15835229565/BMS_SLAVE_V2.0/README.md

BMS_SLAVE_V2.0
==============

ATtiny13 sourec code for HW version 2.0
