15835229565/BMS_SLAVE_V2.0/(list of files, cad)

Other CAD files:
Software/AtTiny_programmer/RC calib Projekt/rc_calib.obj
