15835229565/BMS_SLAVE_V2.0/Hardware/Eagle_project/BMS_Slave_V2.0.brd

## EAGLE design Hardware/Eagle_project/BMS_Slave_V2.0.brd (2015-01-06)

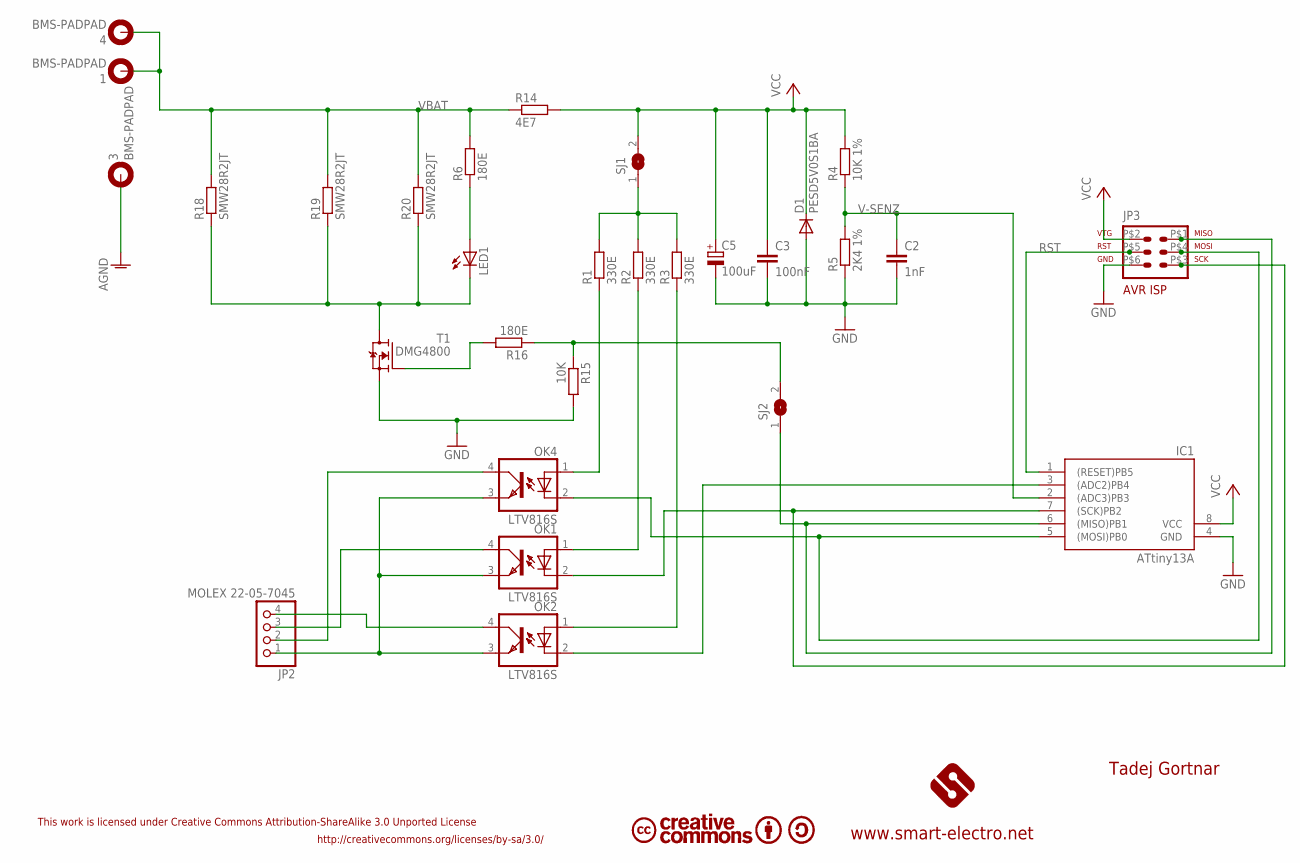
[picture p1: schematic BMS_Slave_V2.0.sch]

Parts:
1, 3, 4: BMS-PADPAD; BMSPAD
C2: 1nF; C0805K
C3: 100nF; C0805K
C5: 100uF; 153CLV-0605
D1: PESD5V0S1BA; SOD323-W
IC1: ATtiny13A; SO08
JP2: MOLEX 22-05-7045; 1X04
JP3: AVR-ISP-6S; 6PAD_ISP_SMD
LED1: LEDCHIP-LED0805; CHIP-LED0805
OK1, OK2, OK4: LTV816S; SMD4
R1, R2, R3: 330E; M0805
R4: 10K 1%; M0805
R5: 2K4 1%; M0805
R6, R16: 180E; M0805
R14: 4E7; M0805
R15: 10K; M0805
R18, R19, R20: SMW28R2JT; R2512W
SJ1, SJ2: SJ
T1: DMG4800; TO252

Connections:
AGND: 3.B5,5
GND: C2.2, C3.2, C5.-, D1.A, IC1.4 (GND), JP3.P$6 (6), R5.1, R15.2, T1.2 (S)
MISO: IC1.6 ((MISO)PB1), JP3.P$1 (1), SJ2.1
MOSI: IC1.5 ((MOSI)PB0), JP3.P$4 (4), OK4.2 (C)
unnamed: JP2.2, OK4.4 (COL)
unnamed: JP2.3, OK1.4 (COL)
unnamed: JP2.4, OK2.4 (COL)
unnamed: R1.2, R2.2, R3.2, SJ1.1
unnamed: LED1.C, R18.1, R19.1, R20.1, T1.3 (D)
unnamed: JP2.1, OK1.3 (EMIT), OK2.3 (EMIT), OK4.3 (EMIT)
unnamed: R16.2, T1.1 (G)
unnamed: R15.1, R16.1, SJ2.2
unnamed: OK4.1 (A), R1.1
unnamed: OK1.1 (A), R2.1
unnamed: OK2.1 (A), R3.1
unnamed: LED1.A, R6.1
unnamed: IC1.3 ((ADC2)PB4), OK2.2 (C)
RST: IC1.1 ((RESET)PB5), JP3.P$5 (5)
SCK: IC1.7 ((SCK)PB2), JP3.P$3 (3), OK1.2 (C)
V-SENZ: C2.1, IC1.2 ((ADC3)PB3), R4.1, R5.2
VBAT: 1.B5,5, 4.B5,5, R6.2, R14.1, R18.2, R19.2, R20.2
VCC: C3.1, C5.+, D1.C, IC1.8 (VCC), JP3.P$2 (2), R4.2, R14.2, SJ1.2

Notes on the sheet:
www.smart-electro.net
http://creativecommons.org/licenses/by-sa/3.0/
Tadej Gortnar
This work is licensed under Creative Commons Attribution-ShareAlike 3.0 Unported License

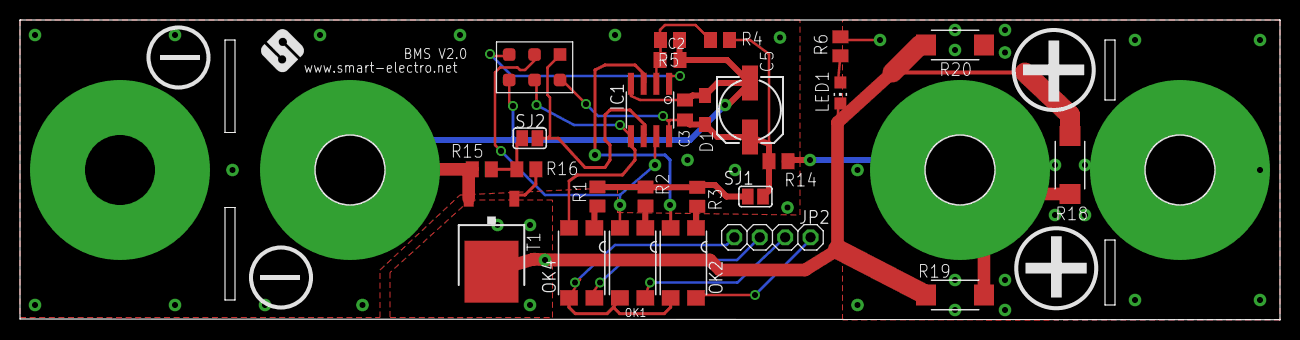
[picture p2: board BMS_Slave_V2.0.brd from above]

Board: 2 copper layers, 126.0 x 30.0 mm, 29 parts (0 on the bottom side), 21 nets.
