15835229565/BMS_SLAVE_V2.0/(commit log)

2014-06-29 initail comit
    [BMS_Slave_V2.0.sch]
2015-01-06 New software with RC calibarion
    [BMS_Slave_V2.0.brd, rc_calib.obj]
